camille42/nanoreseau/Equerre.step

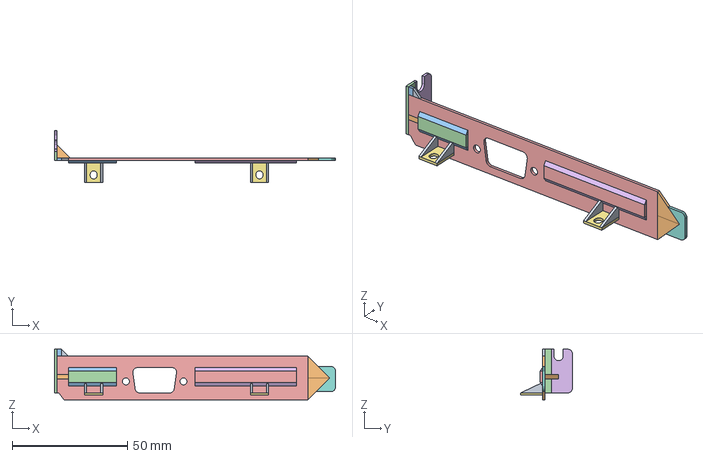
[picture p1: CAD file, 2021-11-15]
Equerre.step
122.0 x 22.5 x 22.0 mm
