camille42/nanoreseau/XTBus.sch

## KiCad design XTBus.sch (2022-01-17)

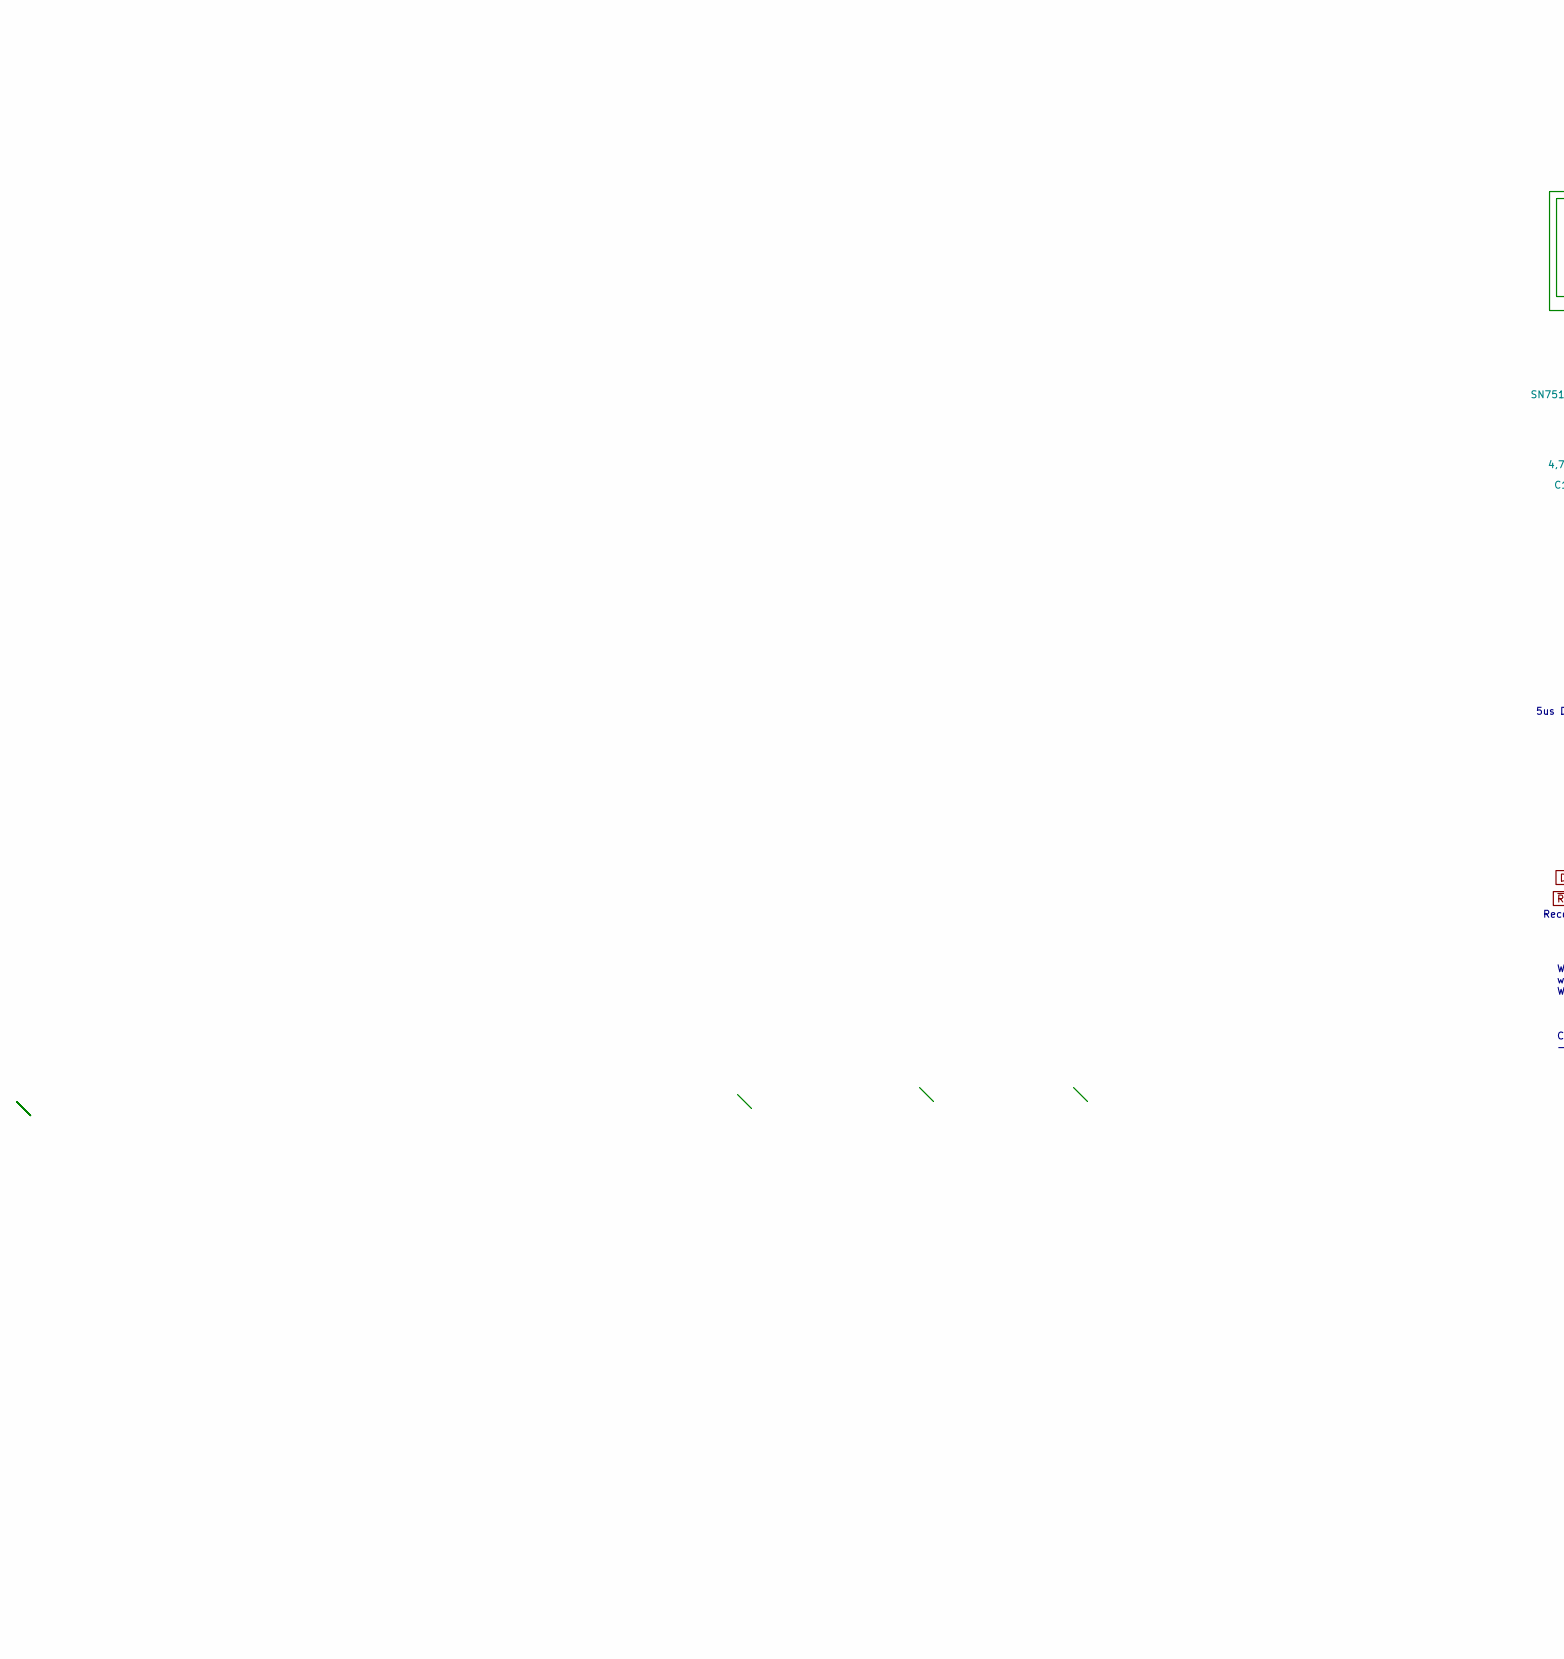
[picture p5: schematic XTBus.sch, part in row 1, column 1]

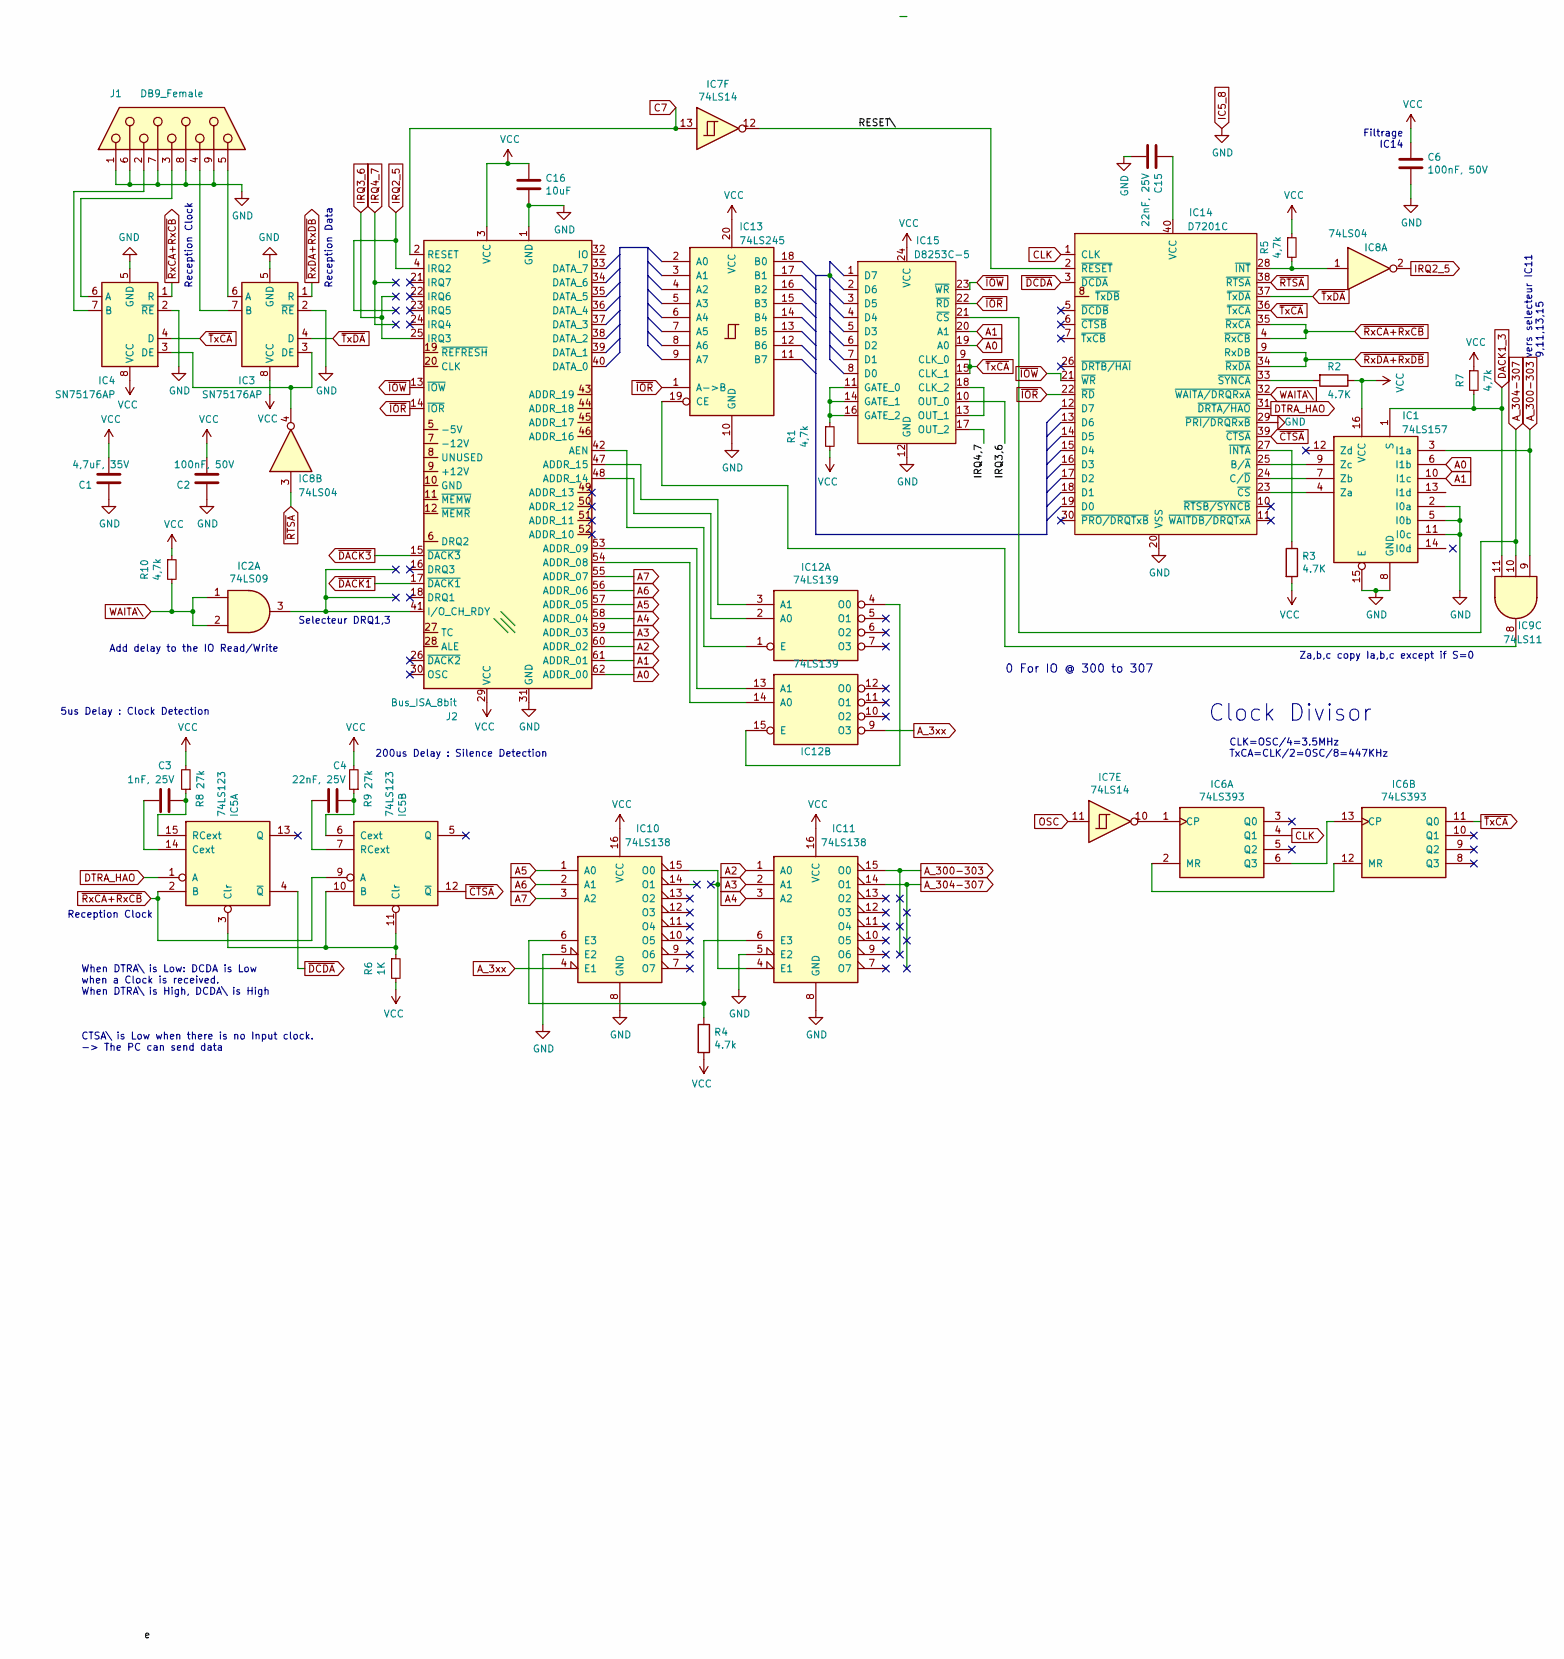
[picture p6: schematic XTBus.sch, part in row 1, column 2]

Parts:
C1: 4,7uF, 35V; C_Disc_D4.3mm_W1.9mm_P5.00mm
C2, C6: 100nF, 50V; R_Axial_DIN0309_L9.0mm_D3.2mm_P12.70mm_Horizontal
C3: 1nF, 25V; C_Disc_D5.0mm_W2.5mm_P5.00mm
C4: 22nF, 25V; C_Disc_D5.0mm_W2.5mm_P5.00mm
C15: 22nF, 25V; C_Disc_D4.3mm_W1.9mm_P5.00mm
C16: 10uF; CP_Radial_D8.0mm_P3.50mm
IC1: 74LS157
IC2: 74LS09; DIP-14_W7.62mm
IC3, IC4: SN75176AP; DIP-8_W7.62mm
IC5: 74LS123; DIP-16_W7.62mm
IC6: 74LS393
IC7: 74LS14
IC8: 74LS04; DIP-14_W7.62mm
IC9: 74LS11
IC10, IC11: 74LS138
IC12: 74LS139
IC13: 74LS245; DIP-20_W7.62mm
IC14: D7201C; DIP-40_W15.24mm
IC15: D8253C-5; DIP-24_W15.24mm
J1: DB9_Female; DSUB-9_Female_Horizontal_P2.77x2.84mm_EdgePinOffset4.94mm_H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
J2: Bus_ISA_8bit; BUS_AT_8bits
R1, R5, R7, R10: 4,7k; R_Axial_DIN0309_L9.0mm_D3.2mm_P12.70mm_Horizontal
R2, R3: 4.7K
R4: 4.7k
R6: 1K; R_Axial_DIN0309_L9.0mm_D3.2mm_P12.70mm_Horizontal
R8, R9: 27k; R_Axial_DIN0309_L9.0mm_D3.2mm_P12.70mm_Horizontal

Connections:
A0: IC1.6 (I1b), IC15.19 (A0), J2.62 (ADDR_00)
A1: IC1.10 (I1c), IC15.20 (A1), J2.61 (ADDR_01)
A2: IC11.1 (A0), J2.60 (ADDR_02)
A3: IC11.2 (A1), J2.59 (ADDR_03)
A4: IC11.3 (A2), J2.58 (ADDR_04)
A5: IC10.1 (A0), J2.57 (ADDR_05)
A6: IC10.2 (A1), J2.56 (ADDR_06)
A7: IC10.3 (A2), J2.55 (ADDR_07)
A_3xx: IC10.4 (E1), IC12.9 (O3)
A_300-303: IC1.3 (I1a), IC9.9, IC11.15 (O0)
A_304-307: IC9.10, IC11.14 (O1), IC15.21 (~CS)
C7: IC7.13, J2.2 (RESET)
CLK: IC6.4 (Q1), IC14.1 (CLK)
DACK1_3: IC1.1 (S), IC9.11, R7.2
DTRA_HAO: IC5.1 (A), IC14.31 (~DRTA/HAO)
GND: C1.1, C2.1, C6.2, C15.2, C16.2, IC1.2 (I0a), IC1.5 (I0b), IC1.8 (GND), IC1.11 (I0c), IC1.15 (E), IC3.2 (~RE), IC3.5 (GND), IC4.2 (~RE), IC4.5 (GND), IC10.5 (E2), IC10.8 (GND), IC11.5 (E2), IC11.8 (GND), IC13.10 (GND), IC14.20 (VSS), IC14.29 (~PRI/DRQRxB), IC15.12 (GND), J1.1, J1.6, J1.7, J1.8, J1.9, J2.1 (GND), J2.31 (GND)
IRQ2_5: IC8.2, J2.4 (IRQ2)
IRQ3,6: IC15.10 (OUT_0)
IRQ3_6: J2.25 (IRQ3)
IRQ4,7: IC15.17 (OUT_2)
unnamed: C3.1, IC5.14 (Cext)
unnamed: C3.2, IC5.15 (RCext), R8.1
unnamed: C4.1, IC5.7 (RCext)
unnamed: C4.2, IC5.6 (Cext), R9.1
unnamed: C15.1, IC14.40 (VCC)
unnamed: IC1.4 (Za), IC14.23 (~CS)
unnamed: IC1.7 (Zb), IC14.24 (C/~D)
unnamed: IC1.9 (Zc), IC14.25 (B/~A)
unnamed: IC2.3, J2.41 (I/O_CH_RDY)
unnamed: IC3.3 (DE), IC4.3 (DE), IC8.4
unnamed: IC3.6 (A), J1.5
unnamed: IC3.7 (B), J1.4
unnamed: IC4.6 (A), J1.3
unnamed: IC4.7 (B), J1.2
unnamed: IC5.3 (Clr), IC5.10 (B), IC5.11 (Clr), R6.1
unnamed: IC6.1 (CP), IC7.10
unnamed: IC6.2 (MR), IC6.12 (MR)
unnamed: IC6.6 (Q3), IC6.13 (CP)
unnamed: IC10.6 (E3), IC11.6 (E3), R4.1
unnamed: IC10.15 (O0), IC11.4 (E1)
unnamed: IC12.1 (E), J2.42 (AEN)
unnamed: IC12.2 (A0), J2.48 (ADDR_14)
unnamed: IC12.3 (A1), J2.47 (ADDR_15)
unnamed: IC12.13 (A1), J2.53 (ADDR_09)
unnamed: IC12.14 (A0), J2.54 (ADDR_08)
unnamed: IC12.4 (O0), IC12.15 (E)
unnamed: IC9.8, IC13.19 (CE)
unnamed: IC14.27 (~INTA), R3.1
unnamed: IC8.1, IC14.28 (~INT), R5.2
unnamed: IC14.33 (~SYNCA), R2.2
unnamed: IC15.11 (GATE_0), IC15.14 (GATE_1), IC15.16 (GATE_2), R1.1
unnamed: IC15.13 (OUT_1), IC15.18 (CLK_2)
OSC: IC7.11
RESET\: IC7.12, IC14.2 (~RESET)
VCC: C1.2, C2.2, C6.1, C16.1, IC1.16 (VCC), IC3.8 (VCC), IC4.8 (VCC), IC10.16 (VCC), IC11.16 (VCC), IC13.20 (VCC), IC15.24 (VCC), J2.3 (VCC), J2.29 (VCC), R1.2, R2.1, R3.2, R4.2, R5.1, R6.2, R7.1, R8.2, R9.2, R10.1
WAITA\: IC2.1, IC2.2, IC14.32 (~WAITA/DRQRxA), R10.2
~CTSA: IC5.12 (~Q), IC14.39 (~CTSA)
~DACK1: J2.17 (~DACK1)
~DACK3: J2.15 (~DACK3)
~DCDA: IC5.4 (~Q), IC14.3 (~DCDA)
~IOR: IC13.1 (A->B), IC14.22 (~RD), IC15.22 (~RD), J2.14 (~IOR)
~IOW: IC14.21 (~WR), IC15.23 (~WR), J2.13 (~IOW)
~RTSA: IC8.3, IC14.38 (~RTSA)
~RxCA+RxCB: IC4.1 (R), IC5.2 (B), IC5.9 (A), IC14.4 (~RxCB), IC14.35 (~RxCA)
~RxDA+RxDB: IC3.1 (R), IC14.9 (RxDB), IC14.34 (~RxDA)
~TxCA: IC4.4 (D), IC6.11 (Q0), IC14.36 (~TxCA), IC15.9 (CLK_0), IC15.15 (CLK_1)
~TxDA: IC3.4 (D), IC14.37 (~TxDA)

Notes on the sheet:
Selecteur DRQ1,3
vers selecteur IC11 9,11,13,15
Clock Divisor
0 For IO @ 300 to 307
Filtrage IC14
When DTRA\ is Low: DCDA is Low when a Clock is received. When DTRA\ is High, DCDA\ is High
CTSA\ is Low when there is no Input clock. -> The PC can send data
CLK=OSC/4=3.5MHz TxCA=CLK/2=OSC/8=447KHz
Za,b,c copy Ia,b,c except if S=0
Add delay to the IO Read/Write
Reception Clock
Reception Data
5us Delay : Clock Detection
200us Delay : Silence Detection
