camille42/nanoreseau/alim.sch

## KiCad design alim.sch (2022-01-17)

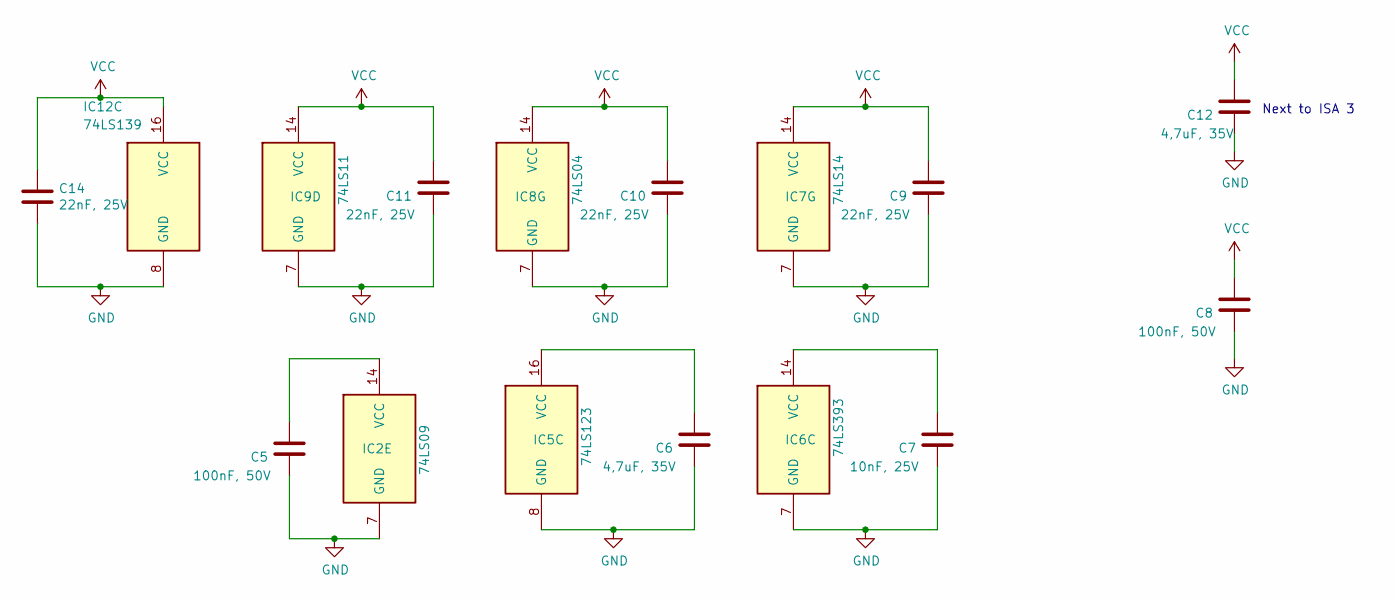
[picture p7: schematic alim.sch]

Parts:
C5, C8: 100nF, 50V; R_Axial_DIN0309_L9.0mm_D3.2mm_P12.70mm_Horizontal
C6, C12: 4,7uF, 35V; C_Disc_D4.3mm_W1.9mm_P5.00mm
C7: 10nF, 25V; C_Disc_D4.3mm_W1.9mm_P5.00mm
C9, C10, C11, C14: 22nF, 25V; C_Disc_D4.3mm_W1.9mm_P5.00mm
IC2: 74LS09; DIP-14_W7.62mm
IC5: 74LS123; DIP-16_W7.62mm
IC6: 74LS393; DIP-14_W7.62mm
IC7: 74LS14; DIP-14_W7.62mm
IC8: 74LS04; DIP-14_W7.62mm
IC9: 74LS11; DIP-14_W7.62mm
IC12: 74LS139; DIP-16_W7.62mm

Connections:
GND: C5.1, C6.1, C7.1, C8.1, C9.1, C10.1, C11.1, C12.1, C14.2, IC2.7 (GND), IC5.8 (GND), IC6.7 (GND), IC7.7 (GND), IC8.7 (GND), IC9.7 (GND), IC12.8 (GND)
unnamed: C5.2, IC2.14 (VCC)
unnamed: C6.2, IC5.16 (VCC)
unnamed: C7.2, IC6.14 (VCC)
VCC: C8.2, C9.2, C10.2, C11.2, C12.2, C14.1, IC7.14 (VCC), IC8.14 (VCC), IC9.14 (VCC), IC12.16 (VCC)

Notes on the sheet:
Next to ISA 3
