camille42/nanoreseau/(commit log)

2021-08-02 première version
    [nano.sch]
2021-08-02 passe2 : verification globale des connexions
2021-08-03 Update README.md
    la BOM
2021-08-03 ajout equerre
    [Equerre.step]
2021-08-03 Passage de témoin
2021-08-03 Nouvelle equerre et déplacement du trou
    [Equerre.step]
2021-08-04 Ecartement des gros pads carrés Corrections de plusieurs pistes vers les puces RS-485 encore Suppression d'une piste sur R3
2021-08-28 Ajout du gerber et des drill de production
    [nano-B_Cu.gbl, nano-B_Mask.gbs, nano-Edge_Cuts.gm1, nano-F_Cu.gtl, nano-F_Mask.gts, nano-F_SilkS.gto, nano-NPTH.drl, nano-PTH.drl]
2021-08-30 verification IC14
    [XTBus.sch, alim.sch]
2021-08-30 oubli de nano.lib
2021-08-31 Nommage des pads ISA
2021-08-31 ajout IRQ/ DRQ
    Pour essayer de comprendre le bus ISA
2021-09-01 modification du bus ISA. ajout de nom sur les pads
    [XTBus.sch, alim.sch]
2021-09-01 les jumpers
    [XTBus.sch, alim.sch]
2021-09-02 Corrections sur IC3 & IC4, nom des pads IC15
    [XTBus.sch]
2021-09-08 Schema de Freddy
    [XTBus.sch, alim.sch]
2021-09-17 Dernière version de Freddy
    [XTBus.sch, alim.sch]
2021-09-21 ajout de doc sur bus ISA
2021-11-05 Dernière version avec les valeurs actuelles de capa et résistance.
    [XTBus.sch]
2021-11-15 Petite mise-à-jour de l'equerre
    [Equerre.step]
2021-11-19 Corrrection BOM et petite correction Schéma
    [XTBus.sch]
2022-01-17 Maj de Freddy
    [XTBus.sch, alim.sch]
